DimiLaprog/Prototype-IR-Signal-Receiver-and-Decoder/Images/breadboard.jpg

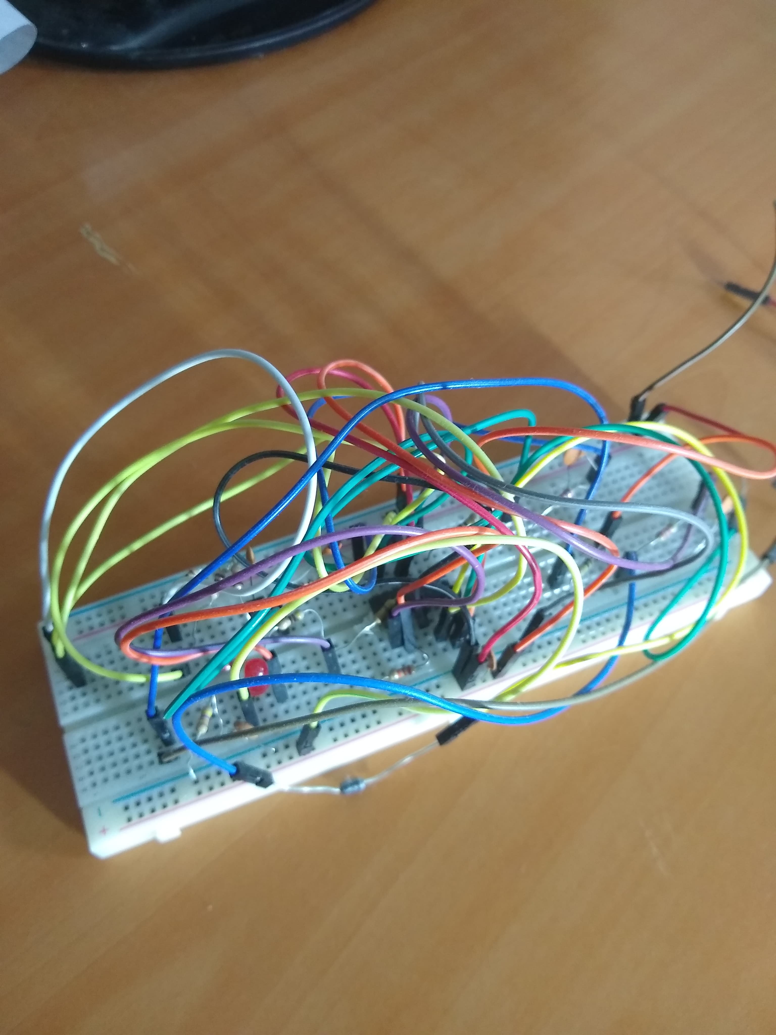
Images/breadboard.jpg
