DimiLaprog/Prototype-IR-Signal-Receiver-and-Decoder/Images/prototype board.jpg

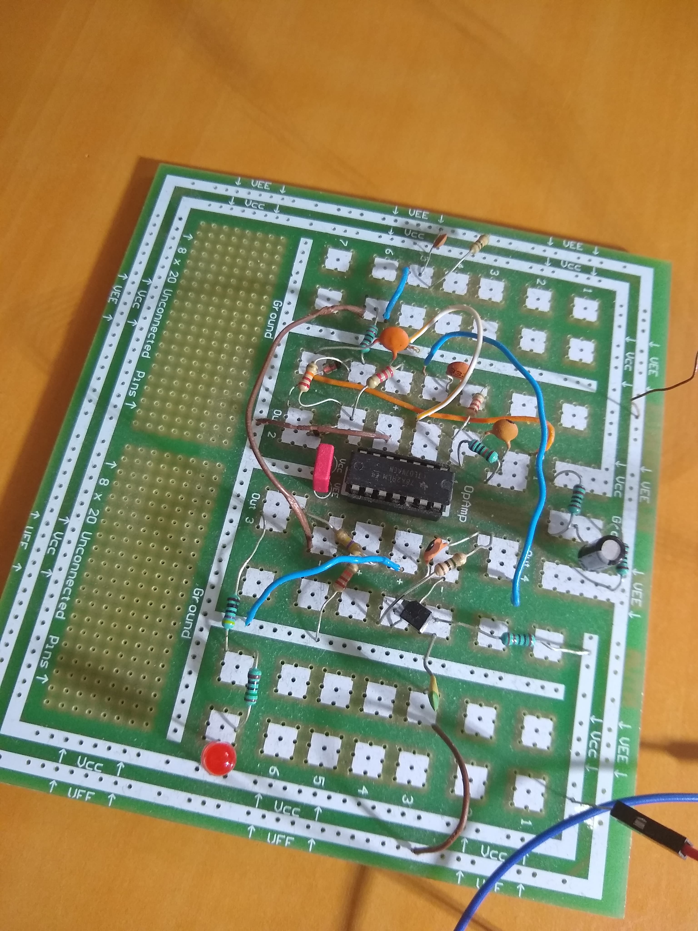
Images/prototype board.jpg
