DimiLaprog/Prototype-IR-Signal-Receiver-and-Decoder/LTSPICE SIM.asc

C1: cap; 3.3n
C2: cap; 33pico
C3: cap; 3.3n
C4: cap; 33n
D1: zener; 1N5371B
D2: zener; 1N5371B
D3: LED
R1: res; 100k
R2: res; 22k
R3: res; 470k
R4: res; 22k
R5: res; 470
R6: res; 150
R7: res; 2.2k
R8: res; 2.2k
R9: res; 10k
R10: res; 2.2k
U1: TL074
U2: TL074
U3: TL074
V1: voltage; ""; AC 0.03
vcc: voltage; 12
VIRTUAL_GROUND: voltage; 6
Named nets: 0
;.tran 0.001
.ac dec 100 1 1mega
