DimiLaprog/Prototype-IR-Signal-Receiver-and-Decoder/Images/test transmitter.jpg

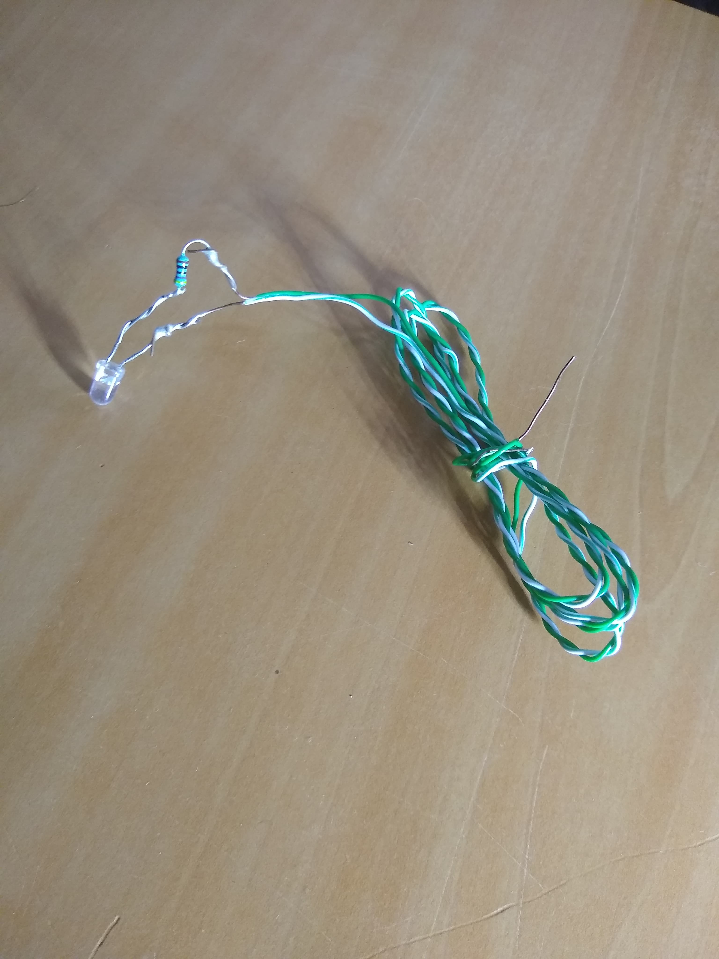
Images/test transmitter.jpg
